oprobst/Punktschweissgeraet/README.md

# Punktschweissgeraet

Schaltpläne, Layouts und Software

See http://www.tief-dunkel-kalt.org/index.php/blog/42-diy-punktschweissgeraet for details (sorry, German only).
