oprobst/Punktschweissgeraet/eagle/FET-Driver-Modul.brd

## EAGLE design eagle/FET-Driver-Modul.brd (2016-06-30)

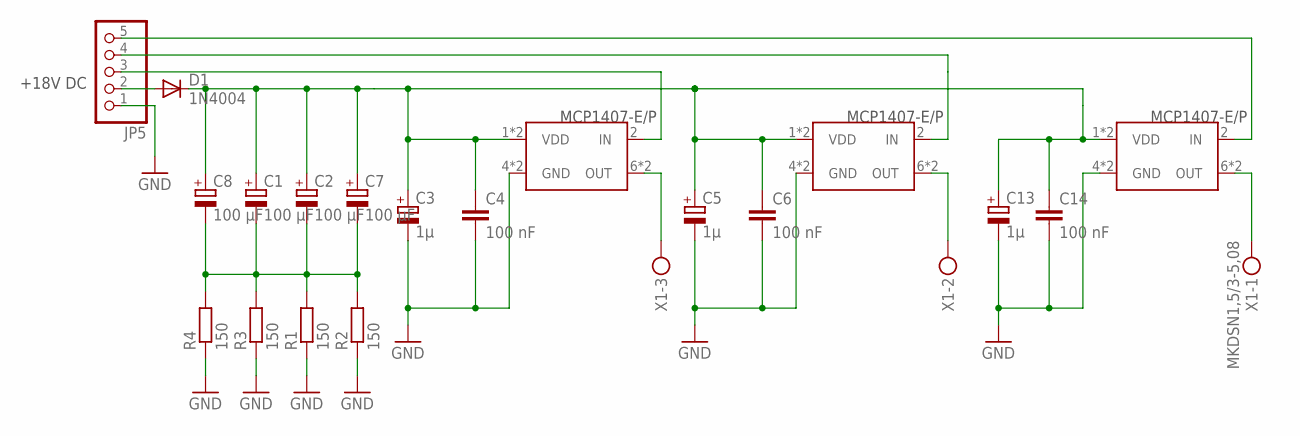
[picture p1: schematic FET-Driver-Modul.sch]

Parts:
C1, C2, C7, C8: 100 µF; E2,5-7
C3, C5, C13: 1µ; E5-8,5
C4, C6, C14: 100 nF; C0603
D1: 1N4004; DO41-10
JP5: PINHD-1X5; 1X05
R1, R2, R3, R4: 150; 0411/15
U$3, U$4, U$5: MCP1407MCP1407-DIL08; DIL-08
X1: MKDSN1,5/3-5,08

Connections:
GND: C3.-, C4.2, C5.-, C6.2, C13.-, C14.2, JP5.1, R1.1, R2.1, R3.1, R4.1, U$3.4 (GND), U$3.5 (GND), U$4.4 (GND), U$4.5 (GND), U$5.4 (GND), U$5.5 (GND)
unnamed: JP5.4, U$4.2 (IN)
unnamed: C1.+, C2.+, C3.+, C4.1, C5.+, C6.1, C7.+, C8.+, C13.+, C14.1, D1.C, U$3.1 (VDD), U$3.8 (VDD), U$4.1 (VDD), U$4.8 (VDD), U$5.1 (VDD), U$5.8 (VDD)
unnamed: JP5.5, U$5.2 (IN)
unnamed: C1.-, C2.-, C7.-, C8.-, R1.2, R2.2, R3.2, R4.2
unnamed: JP5.3, U$3.2 (IN)
unnamed: D1.A, JP5.2
unnamed: U$4.6 (OUT), U$4.7 (OUT), X1.2
unnamed: U$3.6 (OUT), U$3.7 (OUT), X1.3
unnamed: U$5.6 (OUT), U$5.7 (OUT), X1.1

Notes on the sheet:
+18V DC
MCP1407-E/P

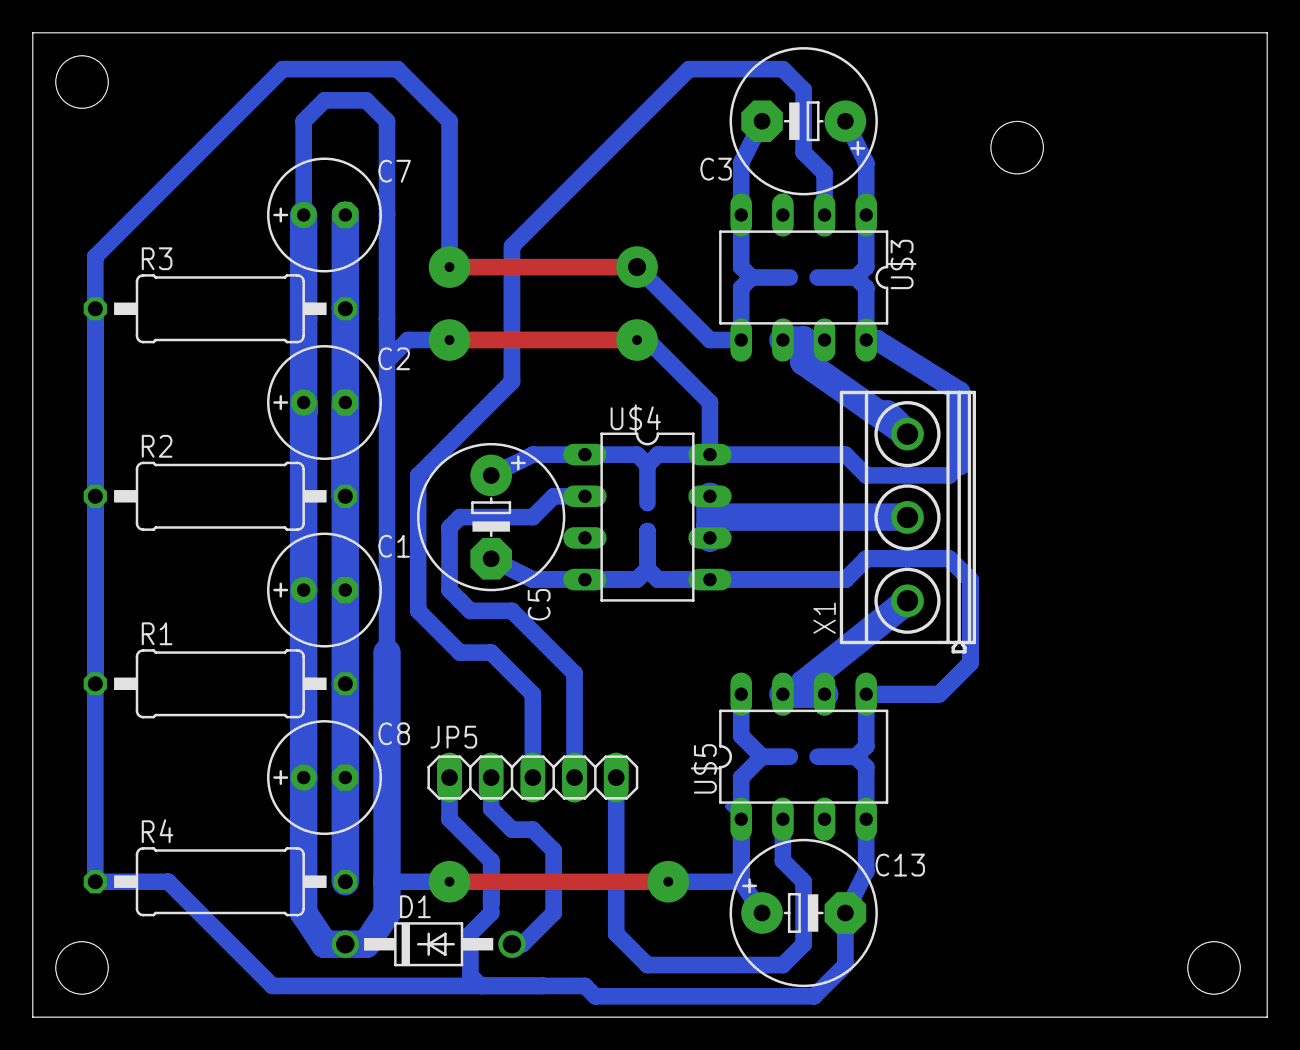
[picture p2: board FET-Driver-Modul.brd from above]

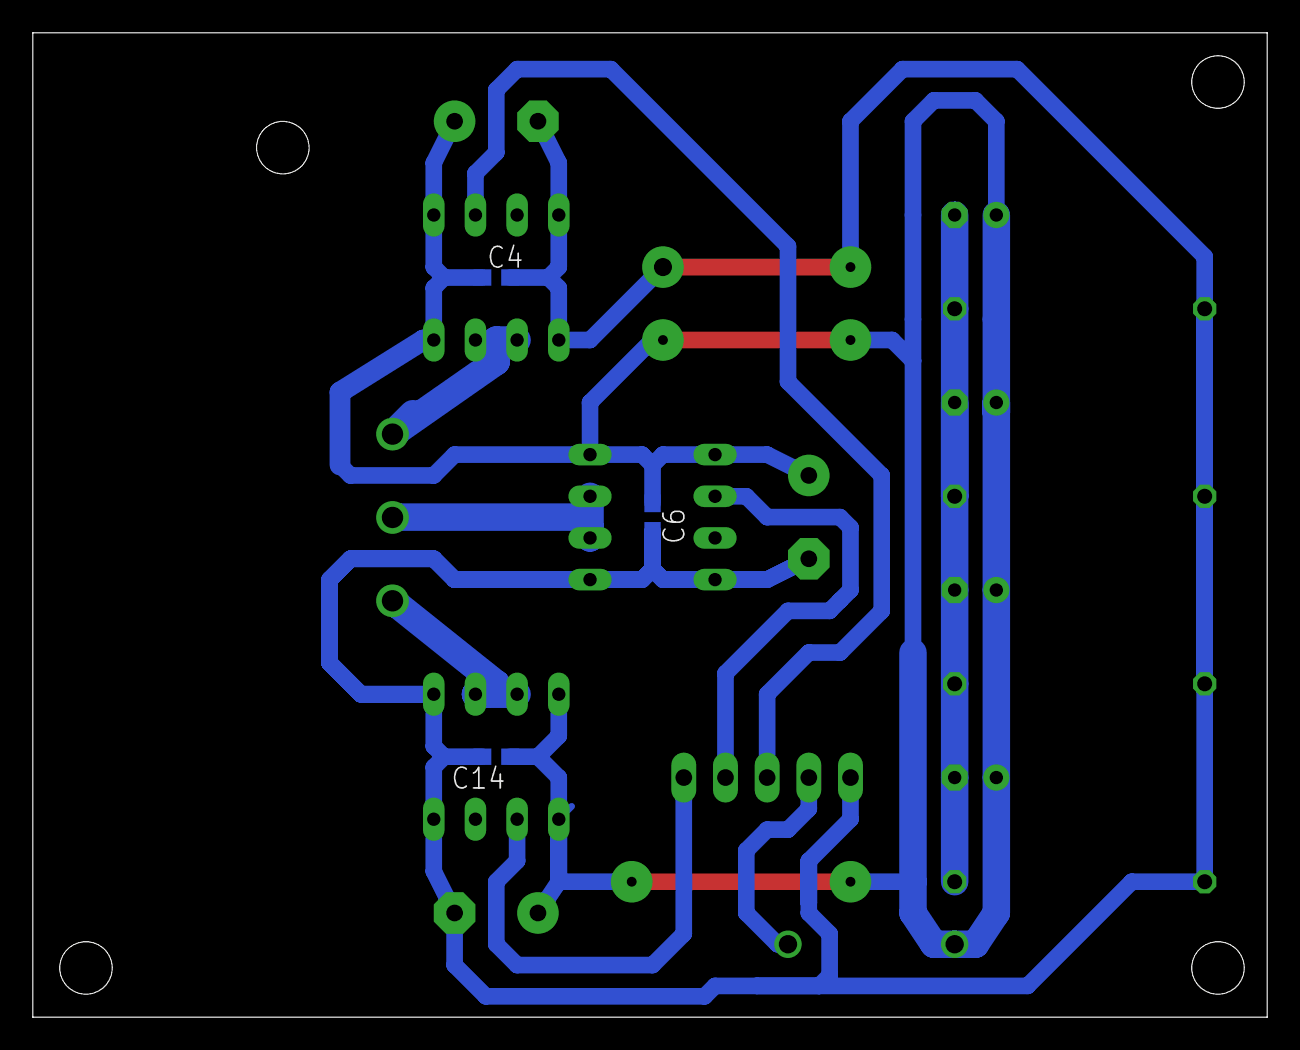
[picture p3: board FET-Driver-Modul.brd from below]

Board: 2 copper layers, 75.2 x 60.0 mm, 20 parts (3 on the bottom side), 10 nets.
