oprobst/Punktschweissgeraet/eagle/Controller-Modul.brd

## EAGLE design eagle/Controller-Modul.brd (2016-05-13)

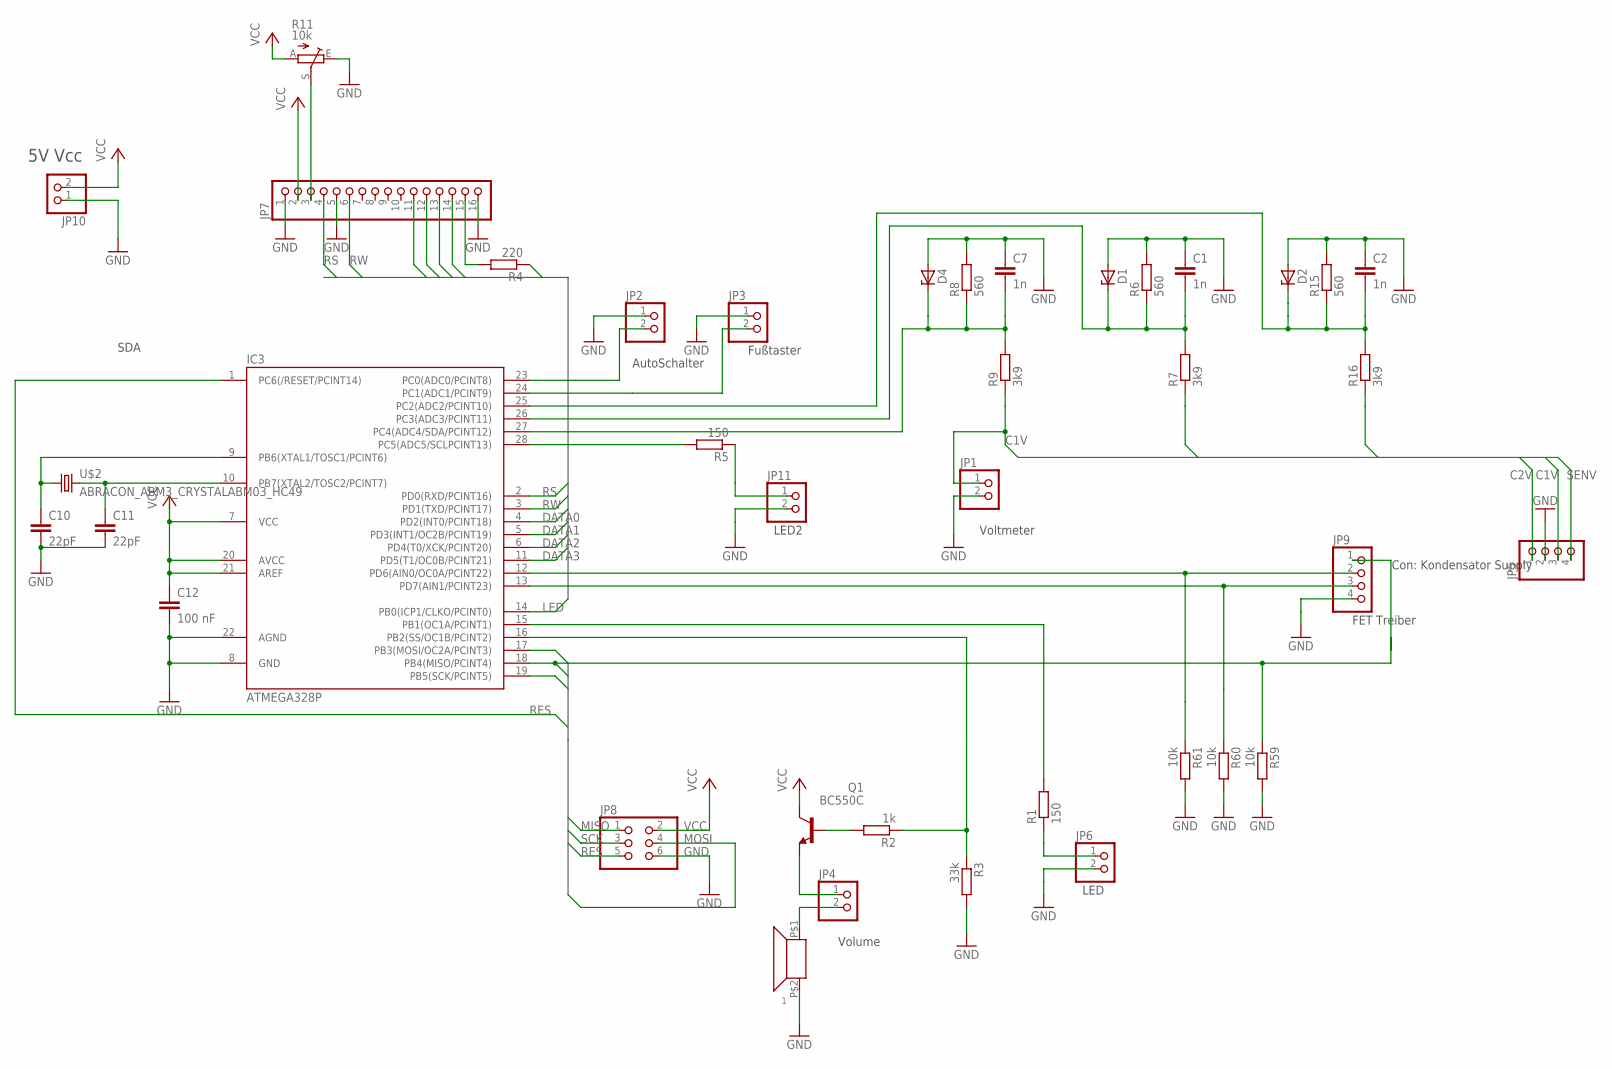
[picture p4: schematic Controller-Modul.sch]

Parts:
1: SUMMER4; PIEZO-INDIKATOR-KPMG
C1, C2, C7: 1n; C0603K
C10, C11: 22pF; C0603K
C12: 100 nF; C0603
D1, D2, D4: ZENER-DIODESOT23; SOT23
IC3: ATMEGA328P; DIL28-3
JP1, JP2, JP3, JP4, JP6, JP10, JP11: PINHD-1X2; 1X02
JP5, JP9: PINHD-1X4; 1X04
JP7: PINHD-1X16; 1X16
JP8: PINHD-2X3; 2X03
Q1: BC550C; TO92-EBC
R1, R5: 150; R1206
R2: 1k; R1206
R3: 33k; R1206
R4: 220; R1206
R6, R8, R15: 560; R1206
R7, R9, R16: 3k9; R1206
R11: 10k; PT-10
R59, R60, R61: 10k; R1206
U$2: ABRACON_ABM3_CRYSTALABM03_HC49; ABM03_HC49

Connections:
C1V: JP1.1, JP5.3, R9.1
C2V: JP5.1, R7.1
DATA0: IC3.4 (PD2(INT0/PCINT18)), JP7.11
DATA1: IC3.5 (PD3(INT1/OC2B/PCINT19)), JP7.12
DATA2: IC3.6 (PD4(T0/XCK/PCINT20)), JP7.13
DATA3: IC3.11 (PD5(T1/OC0B/PCINT21)), JP7.14
FET2: IC3.13 (PD7(AIN1/PCINT23)), JP9.3, R60.1
FET3: IC3.12 (PD6(AIN0/OC0A/PCINT22)), JP9.2, R61.1
GND: 1.P$2 (+), C1.1, C2.1, C7.1, C10.2, C11.2, C12.2, D1.1 (A), D2.1 (A), D4.1 (A), IC3.8 (GND), IC3.22 (AGND), JP1.2, JP2.1, JP3.1, JP5.2, JP6.2, JP7.1, JP7.5, JP7.16, JP8.6, JP9.4, JP10.1, JP11.2, R3.2, R6.2, R8.2, R11.E, R15.2, R59.2, R60.2, R61.2
LED: IC3.14 (PB0(ICP1/CLKO/PCINT0)), R4.1
MISO: IC3.18 (PB4(MISO/PCINT4)), JP8.1, JP9.1, R59.1
MOSI: IC3.17 (PB3(MOSI/OC2A/PCINT3)), JP8.4
unnamed: JP11.1, R5.1
unnamed: IC3.28 (PC5(ADC5/SCLPCINT13)), R5.2
unnamed: Q1.B, R2.2
unnamed: C7.2, D4.3 (C), IC3.27 (PC4(ADC4/SDA/PCINT12)), R8.1, R9.2
unnamed: JP6.1, R1.1
unnamed: C1.2, D1.3 (C), IC3.26 (PC3(ADC3/PCINT11)), R6.1, R7.2
unnamed: IC3.16 (PB2(SS/OC1B/PCINT2)), R2.1, R3.1
unnamed: IC3.23 (PC0(ADC0/PCINT8)), JP2.2
unnamed: JP4.1, Q1.E
unnamed: IC3.24 (PC1(ADC1/PCINT9)), JP3.2
unnamed: 1.P$1 (-), JP4.2
unnamed: C2.2, D2.3 (C), IC3.25 (PC2(ADC2/PCINT10)), R15.1, R16.2
unnamed: IC3.15 (PB1(OC1A/PCINT1)), R1.2
unnamed: C11.1, IC3.10 (PB7(XTAL2/TOSC2/PCINT7)), U$2.2
unnamed: C10.1, IC3.9 (PB6(XTAL1/TOSC1/PCINT6)), U$2.1
unnamed: JP7.3, R11.S
unnamed: JP7.15, R4.2
RES: IC3.1 (PC6(/RESET/PCINT14)), JP8.5
RS: IC3.2 (PD0(RXD/PCINT16)), JP7.4
RW: IC3.3 (PD1(TXD/PCINT17)), JP7.6
SCK: IC3.19 (PB5(SCK/PCINT5)), JP8.3
SENV: JP5.4, R16.1
VCC: C12.1, IC3.7 (VCC), IC3.20 (AVCC), IC3.21 (AREF), JP7.2, JP8.2, JP10.2, Q1.C, R11.A

Notes on the sheet:
SDA
5V Vcc
LED
Volume
Con: Kondensator Supply
Voltmeter
Fußtaster
AutoSchalter
FET Treiber
LED2

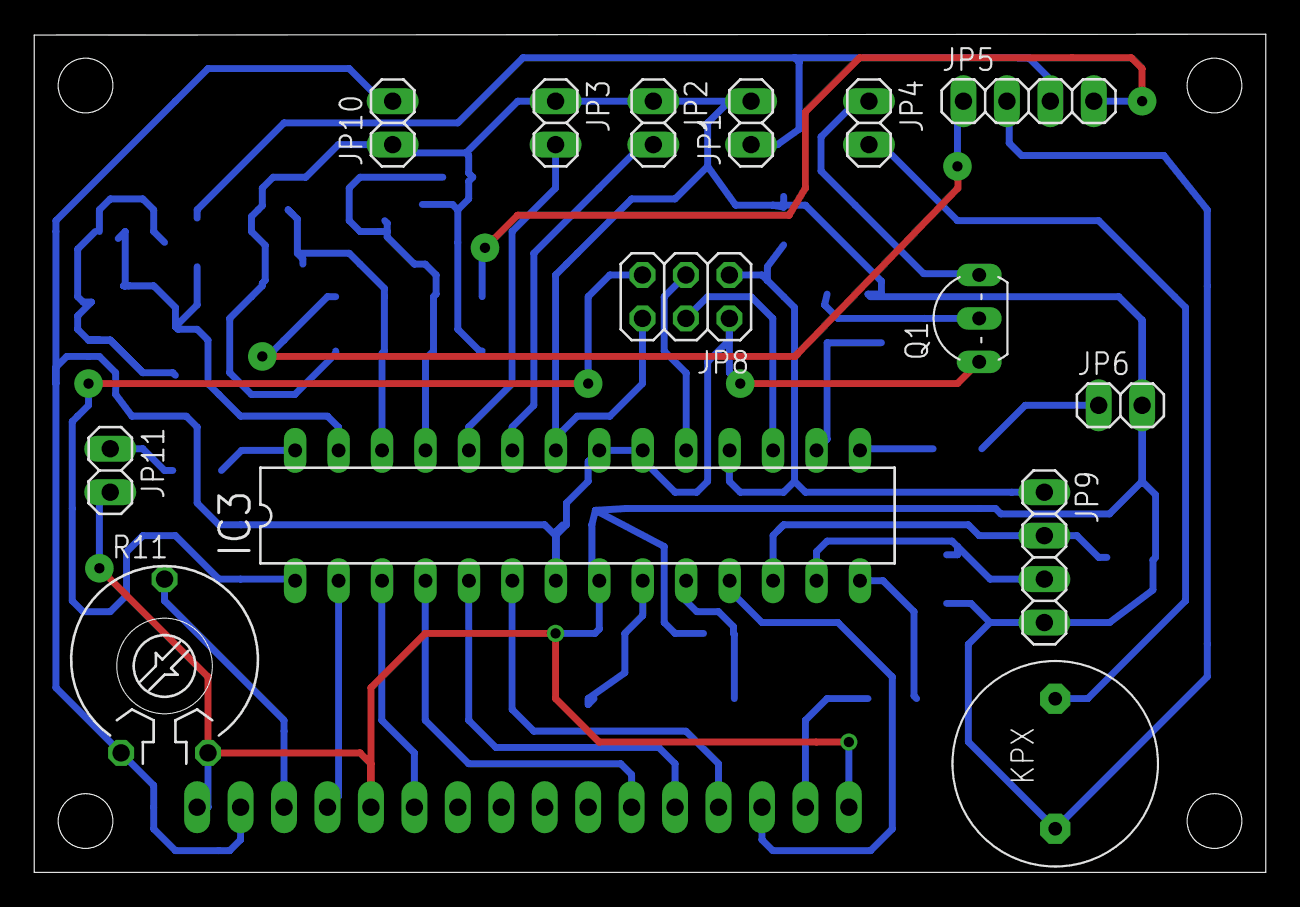
[picture p5: board Controller-Modul.brd from above]

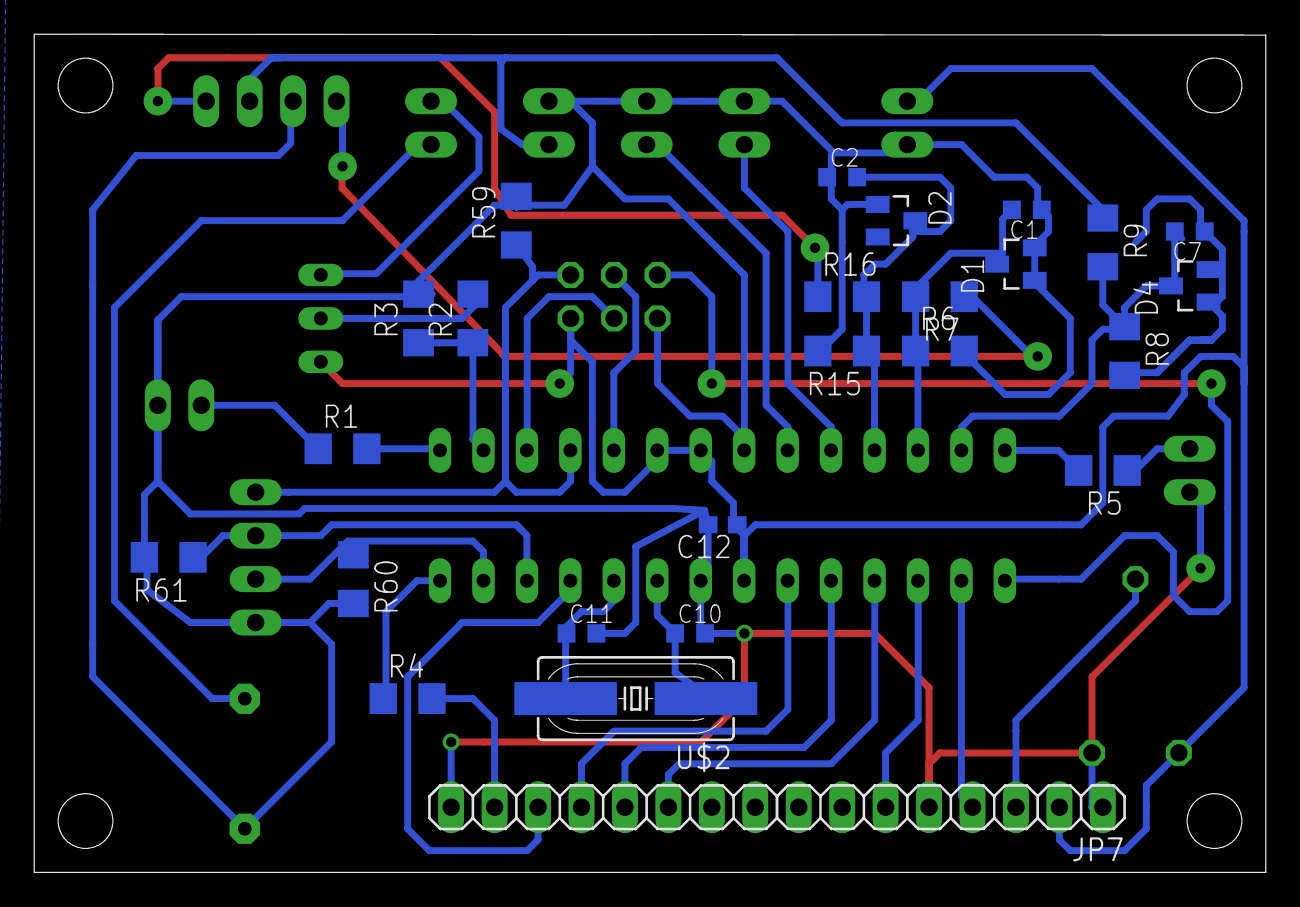
[picture p6: board Controller-Modul.brd from below]

Board: 2 copper layers, 72.0 x 49.0 mm, 39 parts (25 on the bottom side), 35 nets.
