oprobst/Punktschweissgeraet/eagle/Kondensator-Lademodul.brd

## EAGLE design eagle/Kondensator-Lademodul.brd (2016-05-04)

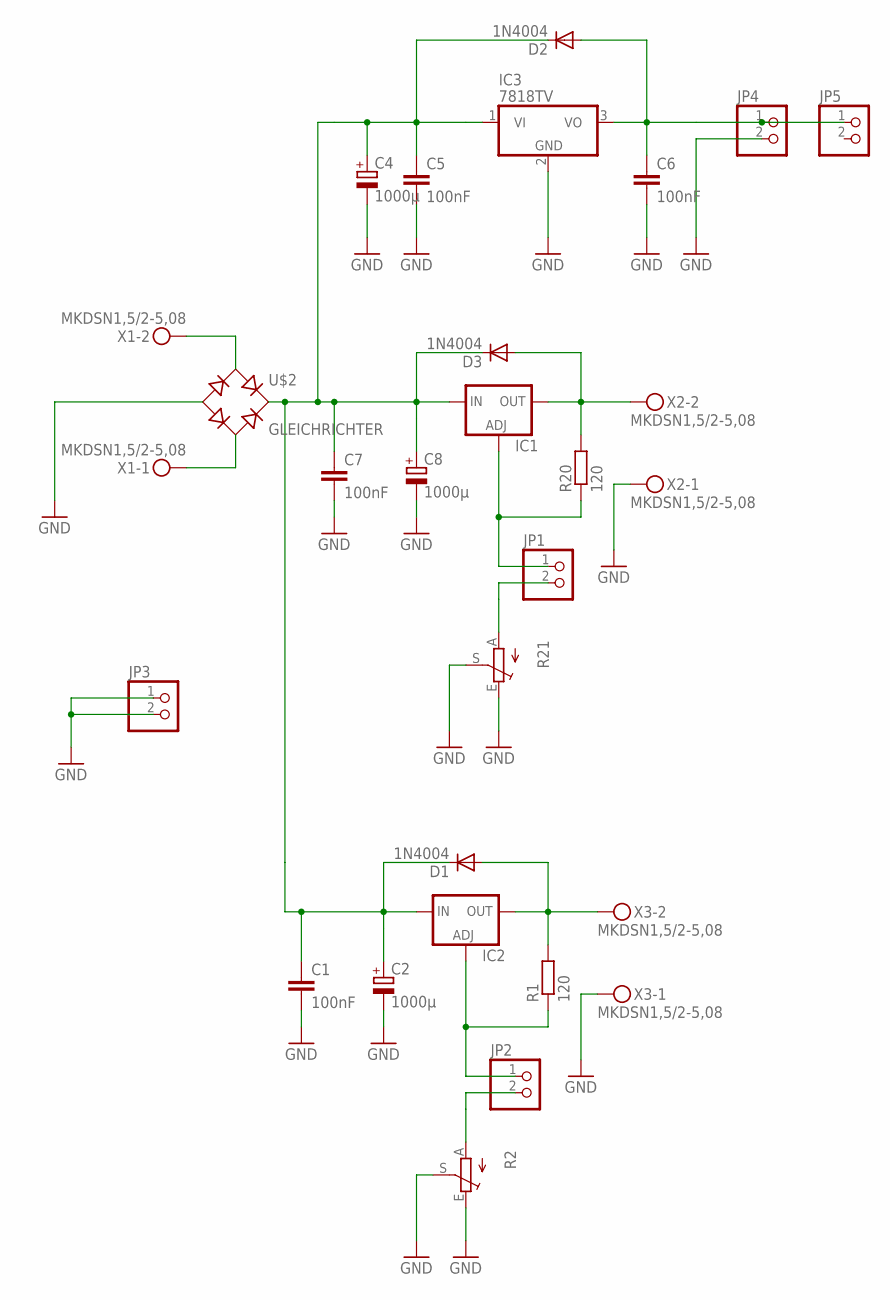
[picture p7: schematic Kondensator-Lademodul.sch]

Parts:
C1, C5, C6, C7: 100nF; C0805
C2, C4, C8: 1000µ; E5-13
D1, D2, D3: 1N4004; DO41-10
IC1, IC2: LM317TS; 317TS
IC3: 7818TV; TO220V
JP1, JP2, JP3, JP4, JP5: PINHD-1X2; 1X02
R1, R20: 120; R1206
R2, R21: TRIM_EU-PT10; PT-10
U$2: GLEICHRICHTER; KBPC1
X1, X2, X3: MKDSN1,5/2-5,08

Connections:
GND: C1.2, C2.-, C4.-, C5.2, C6.2, C7.2, C8.-, IC3.2 (GND), JP3.1, JP3.2, JP4.2, JP5.2, R2.E, R2.S, R21.E, R21.S, U$2.-, X2.1, X3.1
unnamed: C6.1, D2.A, IC3.3 (VO), JP4.1, JP5.1
unnamed: D1.A, IC2.2 (OUT), R1.2, X3.2
unnamed: IC2.1 (ADJ), JP2.1, R1.1
unnamed: JP2.2, R2.A
unnamed: C1.1, C2.+, C4.+, C5.1, C7.1, C8.+, D1.C, D2.C, D3.C, IC1.3 (IN), IC2.3 (IN), IC3.1 (VI), U$2.+
unnamed: U$2.AC1, X1.2
unnamed: U$2.AC2, X1.1
unnamed: D3.A, IC1.2 (OUT), R20.2, X2.2
unnamed: JP1.2, R21.A
unnamed: IC1.1 (ADJ), JP1.1, R20.1

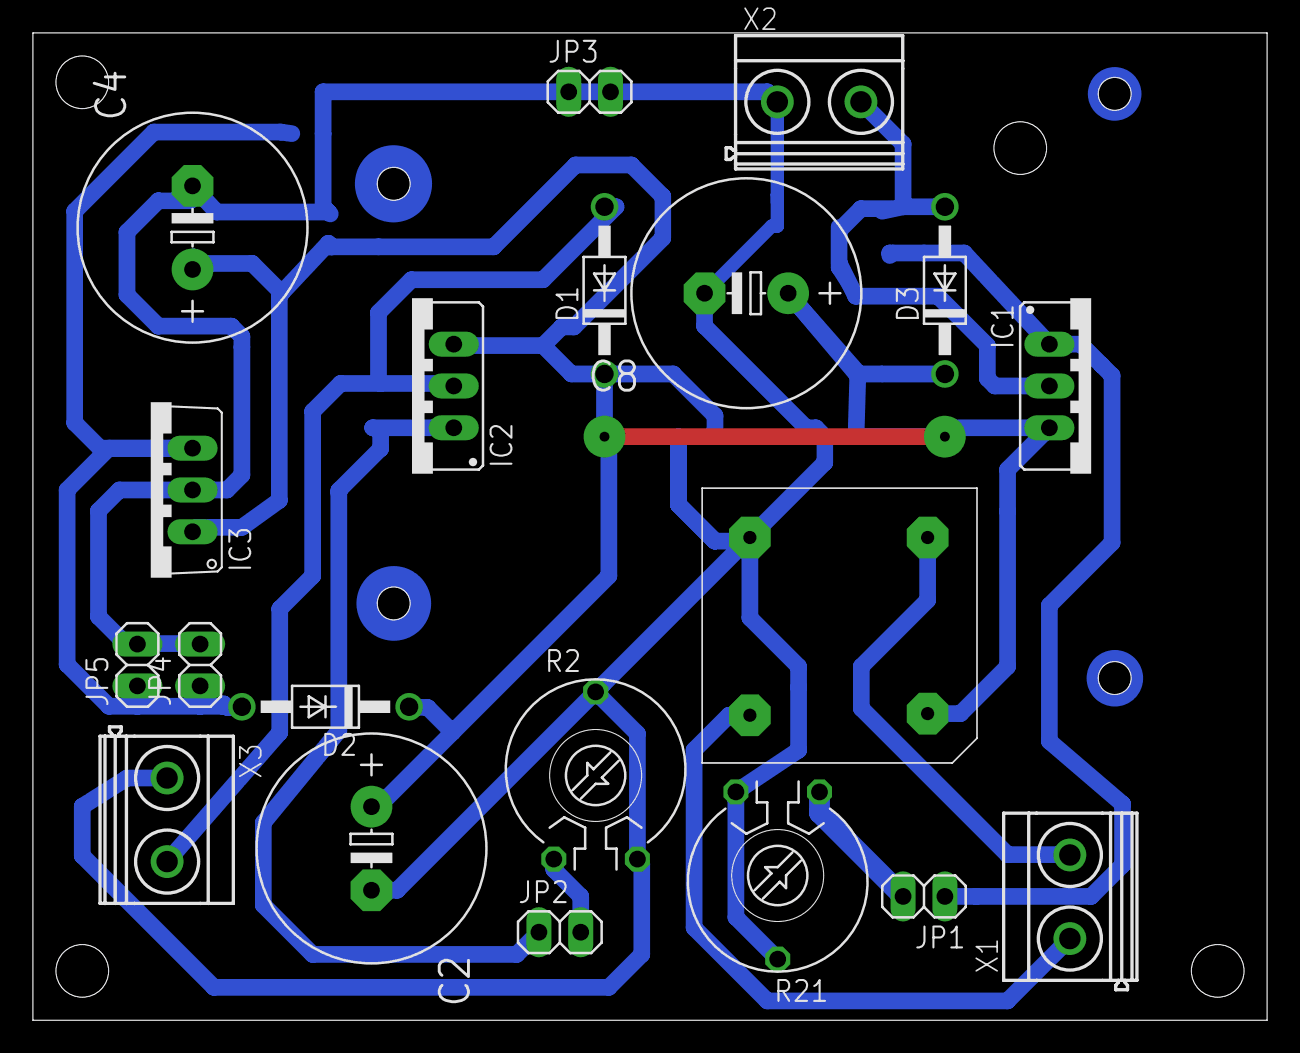
[picture p8: board Kondensator-Lademodul.brd from above]

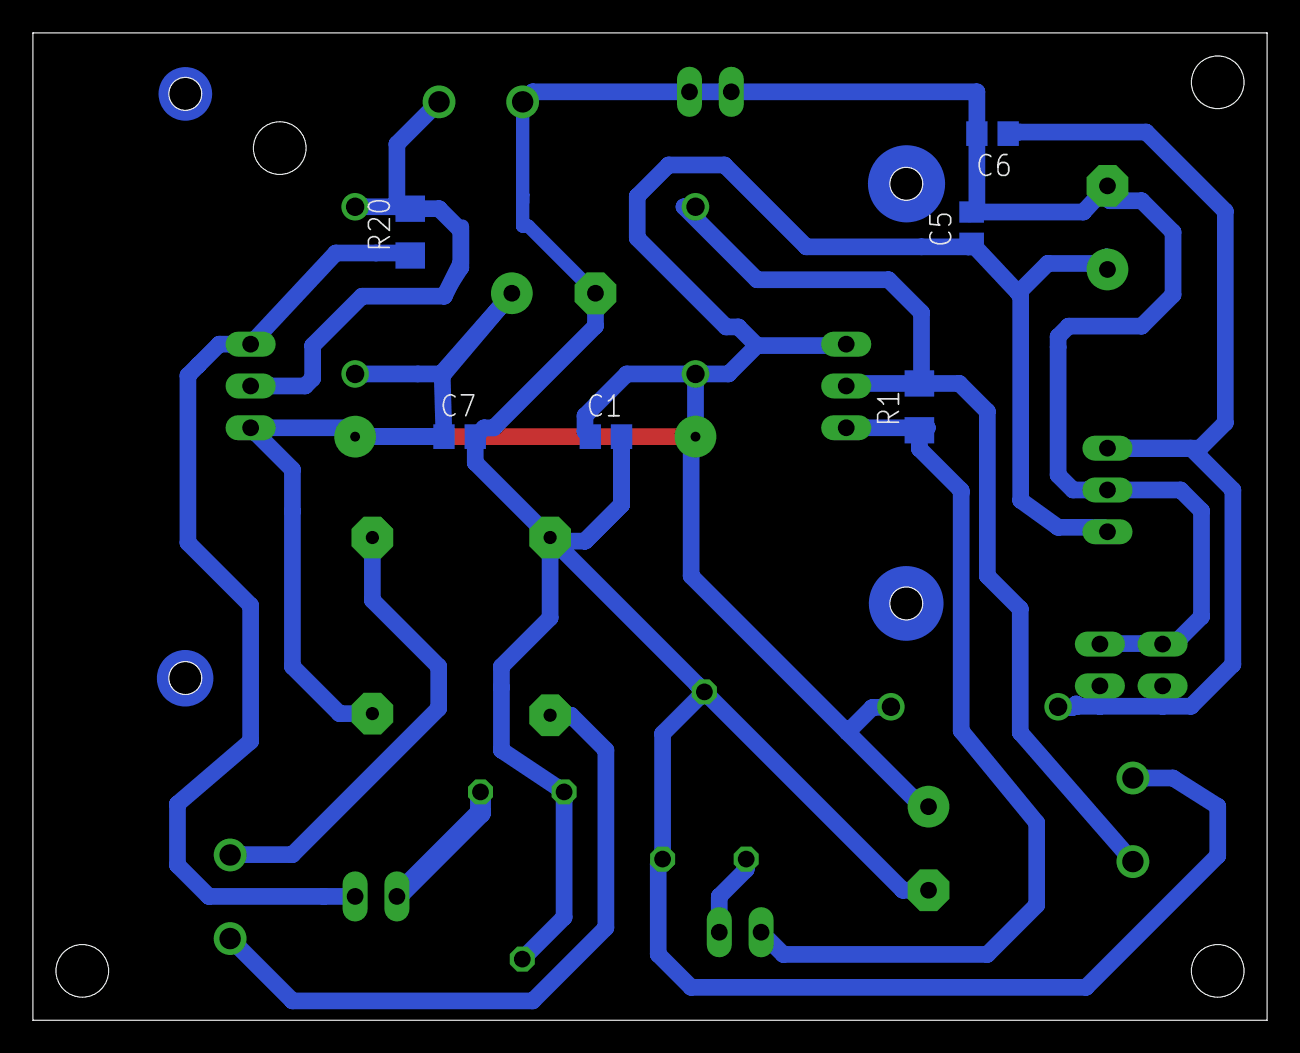
[picture p9: board Kondensator-Lademodul.brd from below]

Board: 2 copper layers, 75.0 x 60.0 mm, 26 parts (6 on the bottom side), 11 nets.
