oprobst/Punktschweissgeraet/eagle/PinBuchse.brd

## EAGLE design eagle/PinBuchse.brd (2016-03-03)

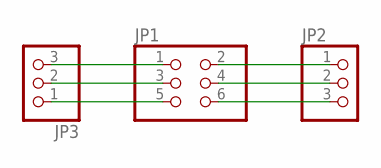
[picture p10: schematic PinBuchse.sch]

Parts:
JP1: PINHD-2X3; 2X03
JP2, JP3: PINHD-1X3; 1X03

Connections:
unnamed: JP1.1, JP3.3
unnamed: JP1.3, JP3.2
unnamed: JP1.5, JP3.1
unnamed: JP1.2, JP2.1
unnamed: JP1.4, JP2.2
unnamed: JP1.6, JP2.3

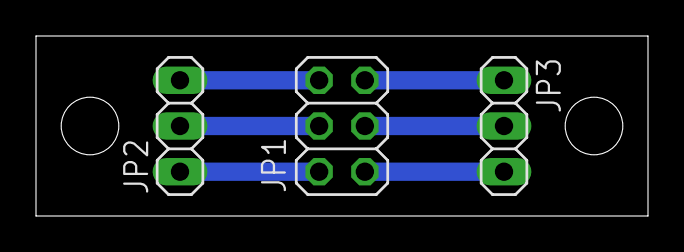
[picture p11: board PinBuchse.brd from above]

Board: 2 copper layers, 34.0 x 10.0 mm, 3 parts (0 on the bottom side), 6 nets.
