oprobst/Punktschweissgeraet/eagle/Controller-Power.brd

## EAGLE design eagle/Controller-Power.brd (2016-03-03)

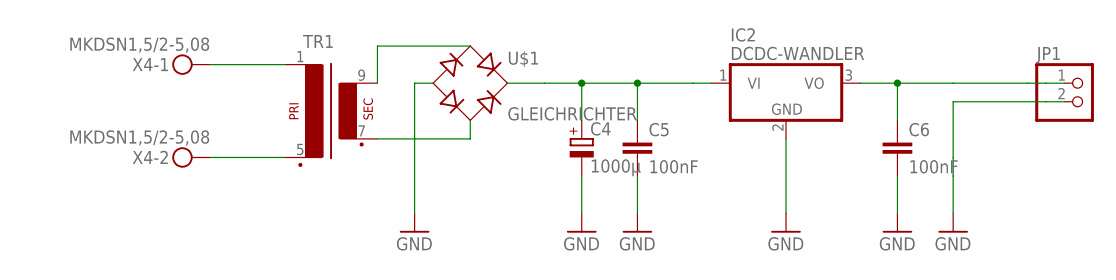
[picture p12: schematic Controller-Power.sch]

Parts:
C4: 1000µ; E3,5-8
C5, C6: 100nF; C0805
IC2: DCDC-WANDLER; TRACOPOWER-DCDCWANDER-TSR1
JP1: PINHD-1X2; 1X02
TR1: EI38-1
U$1: GLEICHRICHTER; KBPC1
X4: MKDSN1,5/2-5,08

Connections:
GND: C4.-, C5.2, C6.2, IC2.2 (GND), JP1.2, U$1.-
unnamed: C4.+, C5.1, IC2.1 (VI), U$1.+
unnamed: TR1.1, X4.1
unnamed: TR1.5 (P2), X4.2
unnamed: TR1.7 (S3), U$1.AC2
unnamed: TR1.9 (S4), U$1.AC1
unnamed: C6.1, IC2.3 (VO), JP1.1

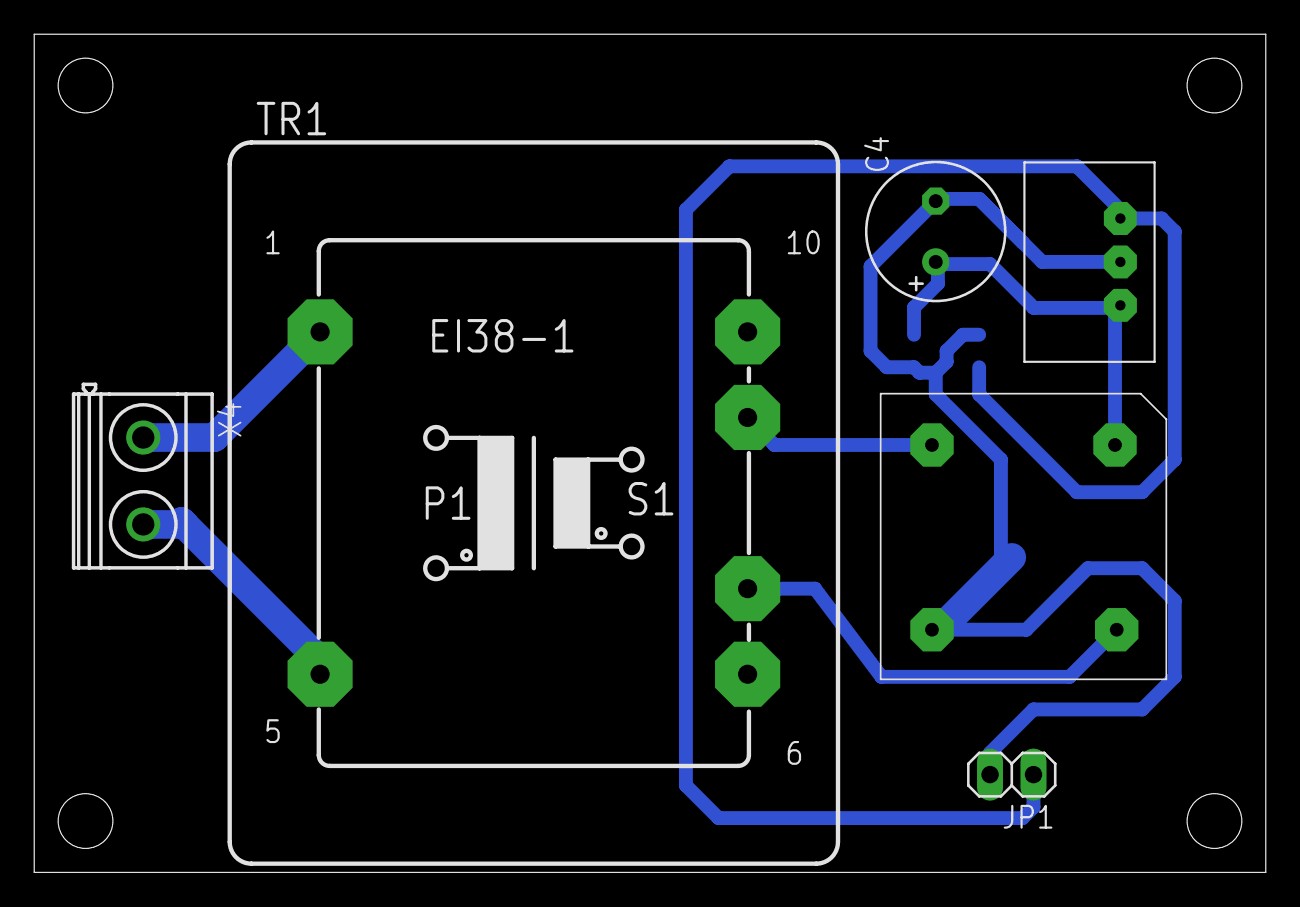
[picture p13: board Controller-Power.brd from above]

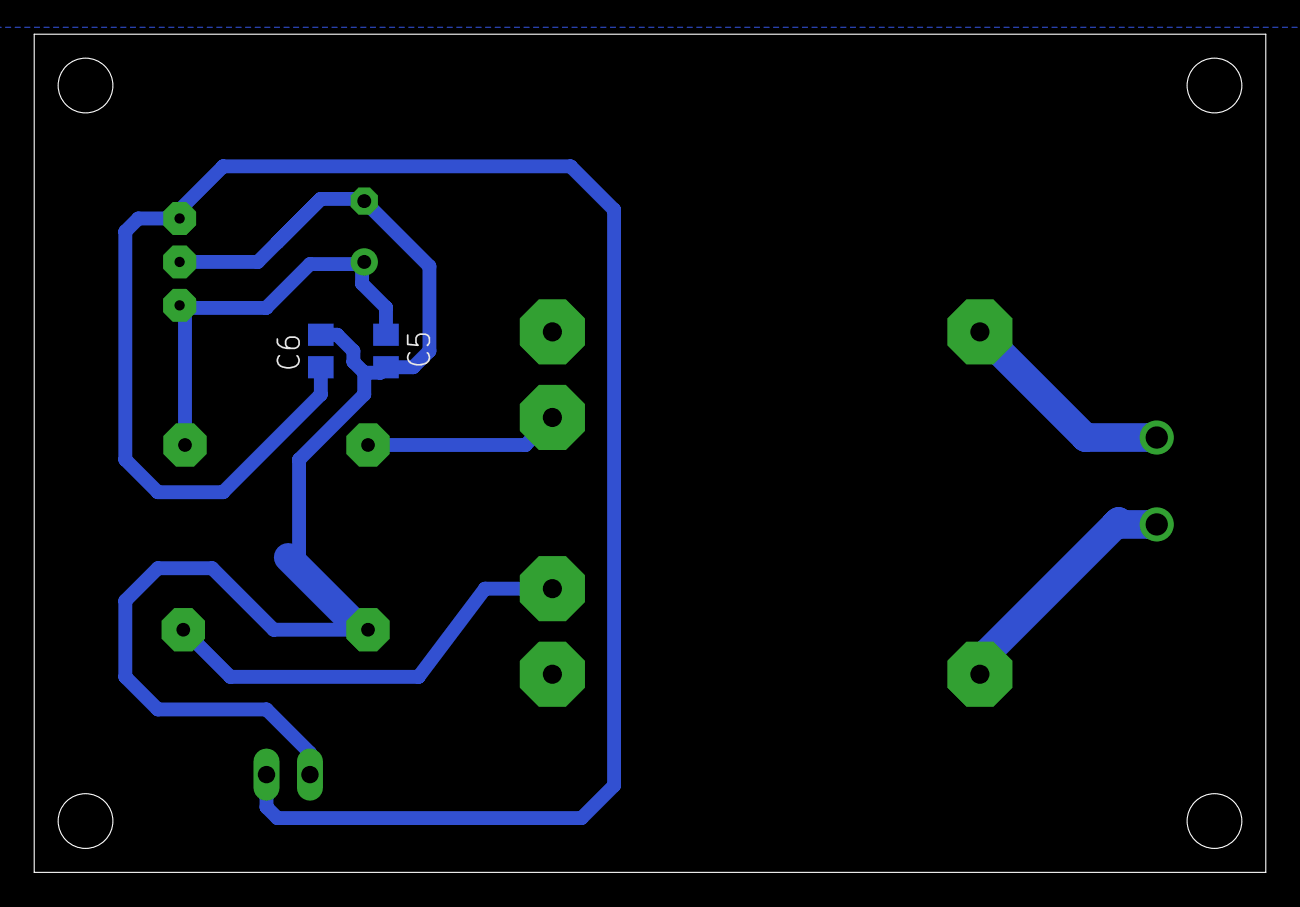
[picture p14: board Controller-Power.brd from below]

Board: 2 copper layers, 72.0 x 49.0 mm, 8 parts (2 on the bottom side), 7 nets.
