oprobst/Punktschweissgeraet/Punktschweissgeraet/Punktschweissgeraet/main.c

#define F_CPU 16000000UL //16 MHz

#define TRUE 1
#define FALSE 0


#define CHARGE_WAIT_TIME 3000 //ms

#define TIME_TO_PUSH_FOR_CALIBRATION 5000 //ms



// LCD DEFINES
#define LCD_IO_MODE   1
#define LCD_PORT   PORTD


#define LCD_DATA0_PIN   5
#define LCD_DATA1_PIN   4
#define LCD_DATA2_PIN   3
#define LCD_DATA3_PIN   2

#define LCD_RS_PORT   PORTD
#define LCD_RS_PIN   0

#define LCD_RW_PORT   PORTB
#define LCD_RW_PIN   5

#define LCD_E_PORT   PORTD
#define LCD_E_PIN   1



#define SWITCH PC0
#define PUSH PC1

#define DISPLAY_LED PB0

#include <avr/io.h>
#include <avr/sleep.h>
#include <util/delay.h>
#include <stdint.h>
#include <avr/interrupt.h>
#include <avr/wdt.h>
#include <avr/eeprom.h>

#include "Gui.h"
#include "lcd-routines.h"
#include "ExecCount.h"
#include "MeasureVoltage.h"
#include "Executor.h"
#include "Calibation.h"

int main(void) {
	initPorts();
	initADC();
	initExecCount();
	initLcd();
	
	//double  val [] = {13.10d, 0.0d};
	//showDischargeCurve(val);
	
	//PINB |= (1<<PB1); //Invert PB4
	
	int8_t enable = FALSE;
	
	showWelcomeScreen();
	showAllExecutions(getAllExecutions());
	showLastCalibration(loadCap1(), loadCap2());
	showReady();
	showIfBothCapActive (TRUE);
	showVoltageHigh(0);
	showVoltageLow(0);
	showTodaysExecutions(0);
	showOhm (0.0f);
	showAmpere (0.0f);
	
	//bit0 = first large C, bit1= second large C, bit2= small c
	uint8_t executeCapacitor = 0b1;
	
	uint8_t executeBoth = (PINC & ( 1 << SWITCH ));
	showIfBothCapActive(executeBoth);

	while (1){
		
		//Check for switch:
		if ( !(PINC & ( 1 << SWITCH))  && executeBoth == TRUE  ) {
			executeBoth = FALSE;
			showIfBothCapActive(executeBoth);
			} else if ( (PINC & ( 1 << SWITCH ))&& executeBoth == FALSE ){ //
			executeBoth = TRUE;
			showIfBothCapActive(executeBoth);
		}
		
		if (readCapVoltage(CONTACT) < 0.25){
			enable = TRUE;
			showContact();
			} else {
			enable = FALSE;
			showReady();
		}
		
		float voltage =  readCapVoltage(C1_VOLT);
		showVoltageHigh(voltage);
		if(1){
			
			if (voltage <= 1 || enable == FALSE){
				executeCapacitor &= ~(1<<0);
				executeCapacitor &= ~(1<<1);
				} else {
				executeCapacitor |= (1<<0);
				if (executeBoth == TRUE){
					executeCapacitor |= (1<<1);
					} else {
					executeCapacitor &= ~(1<<1);
				}
			}
			
			voltage = readCapVoltage(C2_VOLT);
			showVoltageLow(voltage);
			if (voltage <= 1|| enable == FALSE) {
				executeCapacitor &= ~(1<<2);
				} else {
				executeCapacitor |= (1<<2);
			}
			
		}
		//check for push
		if ( ! (PINC & ( 1 << PUSH ))) {
			
			uint16_t count = 0;
			while ( ! (PINC & ( 1 << PUSH ))){
				count++;
				_delay_ms(1);
				if (count > TIME_TO_PUSH_FOR_CALIBRATION){
					break;
				}
			}
			if (count > TIME_TO_PUSH_FOR_CALIBRATION){
				// all cap off! Start calibration.
				showLoading();
				calibrate();
				showReady();
				} else {
				if (enable == FALSE){
					showNoContactErr();
					} else {
					fire(executeCapacitor);
					showTodaysExecutions(getTodaysExections());
					showLoading();
					_delay_ms(CHARGE_WAIT_TIME);
					showReady();
				}
			}
		}
	}
}



void fire (uint8_t executeCapacitor){
	
	struct executionResult result;
	execute(&result, executeCapacitor);
	if (MEASURE_DISCHARGE_CURVE == 1){
		showDischargeCurve(&(result.measuredCurve));
	}
	
	addExecution ();
	showOhm(result.ohmC2);
	showAmpere(result.ampereC2);
	
}

void initPorts (){
	DDRB |= ((1 << PB1) |(1 << PB2) |(0 << PB3) |(1 << PB4) | (1 << PB0));
	DDRC |= ((1 << PC5) | (0 << PC1)|(0 << PC0)|(0 << PC4)|(0 << PC3));
	DDRD |= ((1 << PD6) | (1 << PD7));
	PORTC |= ((1 << PC1)|(1 << PC0));
}
