oprobst/Punktschweissgeraet/Punktschweissgeraet/Punktschweissgeraet/Calibation.h

/*
 * Calibation.h
 *
 * Created: 06.05.2016 08:05:30
 *  Author: Oliver
 */ 


#ifndef CALIBATION_H_
#define CALIBATION_H_


void calibrate ();
double loadCap1();

double loadCap2();

#endif /* CALIBATION_H_ */
