oprobst/Punktschweissgeraet/(commit log)

2016-03-01 Added fet driver
    [FET-Driver-Modul.brd, FET-Driver-Modul.sch]
2016-03-01 pcb design
    [Controller-Modul.brd, Controller-Modul.sch, Kondensator-Lademodul.brd, Kondensator-Lademodul.sch]
2016-03-02 Lots of schema and board changes
    [Controller-Modul.brd, Controller-Modul.sch, Controller-Modul_1.brd, Controller-Modul_1.sch, Controller-Power.brd, Controller-Power.sch, FET-Driver-Modul.brd]
2016-03-03 Adjusted drill positions, little size corrections, new pin header
    [Controller-Modul.brd, Controller-Modul.sch, Controller-Power.brd, FET-Driver-Modul.brd, Kondensator-Lademodul.brd, PinBuchse.brd, PinBuchse.sch]
2016-03-14 Fixed setup of capacitors (bigger and not in conflict)
    [Kondensator-Lademodul.brd, Kondensator-Lademodul.sch, untitled.brd, untitled.sch]
2016-03-20 Var. Changes. Layout and new diode for 7818
    [Controller-Modul.brd, Controller-Modul.sch, Kondensator-Lademodul.brd, Kondensator-Lademodul.sch]
2016-04-02 Updated wrong resistor value
    [Kondensator-Lademodul.brd, Kondensator-Lademodul.sch]
2016-05-04 Added 'Gesamtschaltplan'
    [Gesamtschaltplan.sch, Kondensator-Lademodul.brd]
2016-05-04 added debug output to lcd, little fix for disabling execution on low voltage
    [Gui.h, gui.c, main.c]
2016-05-04 Function to measure voltage
2016-05-06 Reworked the eeprom safe and load mechanism Added functionality for calibrating caps
    [Calibation.h, Calibration.c, ExecCount.c, Executor.c, Executor.h, Gui.h, gui.c, main.c]
2016-05-07 Mainly worked on calibration. Some ui stuff as well. Removed 22k Resistor.
2016-05-07 Removed 22k Resistor
    [Gesamtschaltplan.sch]
2016-05-08 Corrected wrong direction of zener diodes
    [Controller-Modul.brd, Controller-Modul.sch, Gesamtschaltplan.sch]
2016-05-08 A lot of timer stuff for calibration added
2016-05-13 Added forgotten Pull-Down resistors. Lots of new code for executing mosfets
    [Controller-Modul.brd, Controller-Modul.sch, Gesamtschaltplan.sch]
2016-06-26 Minor documentation changes, reduced size of vsens Resistor to detect contact
    [FET-Driver-Modul.brd, FET-Driver-Modul.sch, Gesamtschaltplan.sch, Kondensator-Lademodul.sch]
2016-06-26 Formatting issues displaying ampere and ohm
    [gui.c]
2016-06-26 Reduced contact voltage boundary
2016-06-27 fix: Ampere now measured, read/write executions saved correctly
    [Executor.c, Executor.h, Gui.h]
2016-06-27 additional diode at Mosfet driver
    [FET-Driver-Modul.brd, FET-Driver-Modul.sch, Gesamtschaltplan.sch]
2016-06-30 added diode to driver power supply
    [FET-Driver-Modul.sch, Gesamtschaltplan.sch]
2016-06-30 Added missing GND connector for mosfet driver
    [FET-Driver-Modul.brd]
2016-06-30 Enhanced calculation of aprox. current
